Bohlebots-Sarcat/sarcat-bottom-pcb/README.md

# main/sarcat-bottom-pcb

## Sarcat PCB
___
Bohlebots Sarcat bottom circuit board
