Bohlebots-Sarcat/sarcat-bottom-pcb/bottomPCB/bottomPCB.kicad_pcb

## KiCad design bottomPCB/bottomPCB.kicad_pcb (2024-07-11)

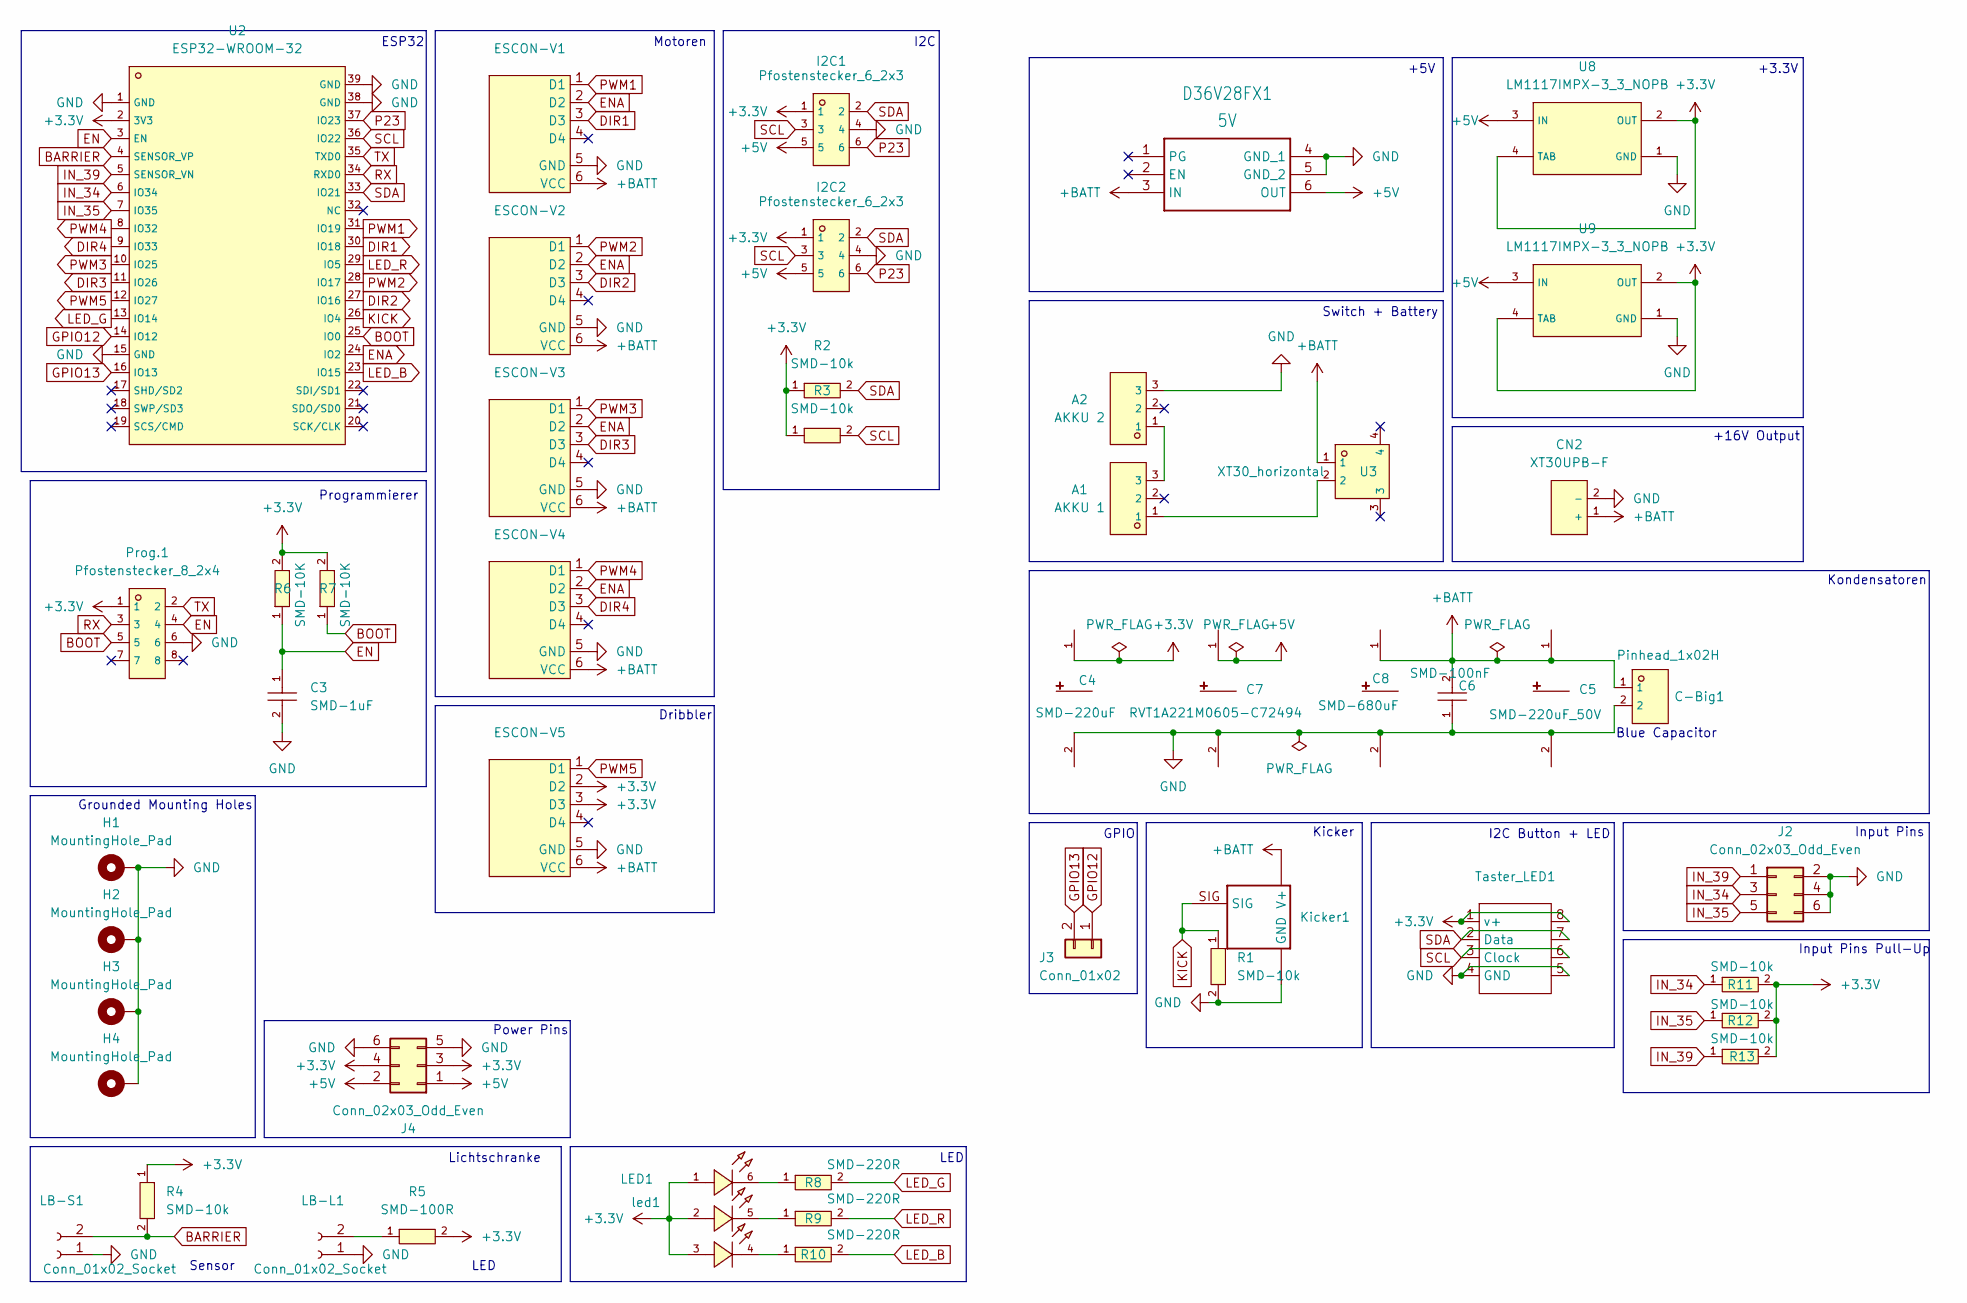
[picture p1: schematic bottomPCB.kicad_sch]

Parts:
A1: AKKU 1; CONN-TH_XH-3AW-C722865; LCSC C722865
A2: AKKU 2; CONN-TH_XH-3AW-C722865; LCSC C722865
C3: SMD-1uF; C0603; LCSC C1592
C4: SMD-220uF; CAP-SMD_BD10.0-L10.3-W10.3-LS11.3-FD; LCSC C125977
C5: SMD-220uF_50V; CAP-SMD_BD10.0-L10.3-W10.3-LS11.3-FD; LCSC C125977
C6: SMD-100nF; C0603; LCSC C30926
C7: RVT1A221M0605-C72494; CAP-SMD_BD10.0-L10.3-W10.3-LS11.3-FD; LCSC C125977
C8: SMD-680uF; CAP-SMD_BD10.0-L10.3-W10.3-LS11.3-FD; LCSC C335987
C-Big1: Pinhead_1x02H; HDR-TH_2P-P2.54-H-M-W10.4; LCSC C492410
CN2: XT30UPB-F; CONN-TH_XT30UPB-F; LCSC C108769
D36V28FX1: 5V; D36V28FX
ESCON-V1, ESCON-V2, ESCON-V3, ESCON-V4, ESCON-V5: ESCON-V
H1, H2, H3, H4: MountingHole_Pad; MountingHole_4.3mm_M4_Pad
I2C1, I2C2: Pfostenstecker_6_2x3; HDR-TH_6P-P2.54-V-F-R2-C3-S2.54-4; LCSC C5372863
J2, J4: Conn_02x03_Odd_Even; PinSocket_2x03_P2.54mm_Vertical
J3: Conn_01x02; PinSocket_1x02_P2.54mm_Vertical
Kicker1: KICKER
LB-L1: Conn_01x02_Socket; PinSocket_1x02_P2.54mm_Vertical
LB-S1: Conn_01x02_Socket; PinSocket_1x02_P2.54mm_Vertical
LED1: led1; LED-SMD_6P-L5.0-W5.0-TL_TC5050RGBF08; LCSC C784540
Prog.1: Pfostenstecker_8_2x4; IDC-TH_8P-P2.54-V-R2-C4-S2.54; LCSC C5372864
R1, R2, R3, R4, R11, R12, R13: SMD-10k; R0603; LCSC C25804
R5: SMD-100R; R0603; LCSC C22775
R6, R7: SMD-10K; R0603; LCSC C25804
R8, R9, R10: SMD-220R; R0603; LCSC C217883
Taster_LED1: TASTER_LED
U2: ESP32-WROOM-32; WIFIM-SMD_ESP32-WROOM-32-N4; LCSC C82899
U3: XT30_horizontal; CONN-TH_XT30PW-M; LCSC C431092
U8, U9: LM1117IMPX-3_3_NOPB; SOT-223_L6.5-W3.5-P2.30-LS7.0-BR; LCSC C23984

Connections:
+3.3V: C4.1, ESCON-V5.2 (D2), ESCON-V5.3 (D3), I2C1.1, I2C2.1, J4.3, J4.4, LED1.1 (+), LED1.2 (+), LED1.3 (+), Prog.1.1, R2.1, R3.1, R4.1, R5.2, R6.2, R7.2, R11.2, R12.2, R13.2, Taster_LED1.1 (v+), Taster_LED1.8, U2.2 (3V3), U8.2 (OUT), U8.4 (TAB), U9.2 (OUT), U9.4 (TAB)
+5V: C7.1, D36V28FX1.6 (OUT), I2C1.5, I2C2.5, J4.1, J4.2, U8.3 (IN), U9.3 (IN)
+BATT: C5.1, C6.2, C8.1, C-Big1.1, CN2.1 (+), D36V28FX1.3 (IN), ESCON-V1.6 (VCC), ESCON-V2.6 (VCC), ESCON-V3.6 (VCC), ESCON-V4.6 (VCC), ESCON-V5.6 (VCC), Kicker1.V+1 (V+), Kicker1.V+2 (V+), Kicker1.V+3 (V+), U3.1
BARRIER: LB-S1.2, R4.2, U2.4 (SENSOR_VP)
BOOT: Prog.1.5, R7.1, U2.25 (IO0)
DIR1: ESCON-V1.3 (D3), U2.30 (IO18)
DIR2: ESCON-V2.3 (D3), U2.27 (IO16)
DIR3: ESCON-V3.3 (D3), U2.11 (IO26)
DIR4: ESCON-V4.3 (D3), U2.9 (IO33)
EN: C3.1, Prog.1.4, R6.1, U2.3 (EN)
ENA: ESCON-V1.2 (D2), ESCON-V2.2 (D2), ESCON-V3.2 (D2), ESCON-V4.2 (D2), U2.24 (IO2)
GND: A2.3, C3.2, C4.2, C5.2, C6.1, C7.2, C8.2, C-Big1.2, CN2.2 (-), D36V28FX1.4 (GND_1), D36V28FX1.5 (GND_2), ESCON-V1.5 (GND), ESCON-V2.5 (GND), ESCON-V3.5 (GND), ESCON-V4.5 (GND), ESCON-V5.5 (GND), H1.1, H2.1, H3.1, H4.1, I2C1.4, I2C2.4, J2.2, J2.4, J2.6, J4.5, J4.6, Kicker1.GND1 (GND), Kicker1.GND2 (GND), Kicker1.GND3 (GND), Kicker1.GND4 (GND), Kicker1.GND5 (GND), Kicker1.GND6 (GND), Kicker1.GND7 (GND), Kicker1.GND8 (GND), LB-L1.1, LB-S1.1, Prog.1.6, R1.2, Taster_LED1.4 (GND), Taster_LED1.5, U2.1 (GND), U2.15 (GND), U2.38 (GND), U2.39 (GND), U8.1 (GND), U9.1 (GND)
GPIO12: J3.1, U2.14 (IO12)
GPIO13: J3.2, U2.16 (IO13)
IN_34: J2.3, R11.1, U2.6 (IO34)
IN_35: J2.5, R12.1, U2.7 (IO35)
IN_39: J2.1, R13.1, U2.5 (SENSOR_VN)
KICK: Kicker1.SIG, R1.1, U2.26 (IO4)
LED_B: R10.2, U2.23 (IO15)
LED_G: R8.2, U2.13 (IO14)
LED_R: R9.2, U2.29 (IO5)
unnamed: A1.1, U3.2
unnamed: A1.3, A2.1
unnamed: LB-L1.2, R5.1
unnamed: LED1.4 (-), R10.1
unnamed: LED1.5 (-), R9.1
unnamed: LED1.6 (-), R8.1
P23: I2C1.6, I2C2.6, U2.37 (IO23)
PWM1: ESCON-V1.1 (D1), U2.31 (IO19)
PWM2: ESCON-V2.1 (D1), U2.28 (IO17)
PWM3: ESCON-V3.1 (D1), U2.10 (IO25)
PWM4: ESCON-V4.1 (D1), U2.8 (IO32)
PWM5: ESCON-V5.1 (D1), U2.12 (IO27)
RX: Prog.1.3, U2.34 (RXD0)
SCL: I2C1.3, I2C2.3, R3.2, Taster_LED1.3 (Clock), Taster_LED1.6, U2.36 (IO22)
SDA: I2C1.2, I2C2.2, R2.2, Taster_LED1.2 (Data), Taster_LED1.7, U2.33 (IO21)
TX: Prog.1.2, U2.35 (TXD0)

Notes on the sheet:
Switch + Battery
Grounded Mounting Holes
Dribbler
LED
Motoren
Kondensatoren
+16V Output
I2C Button + LED
I2C
Input Pins
Input Pins Pull-Up
GPIO
Sensor
ESP32
+3.3V
LED
+5V
Kicker
Lichtschranke
Programmierer
Blue Capacitor
Power Pins

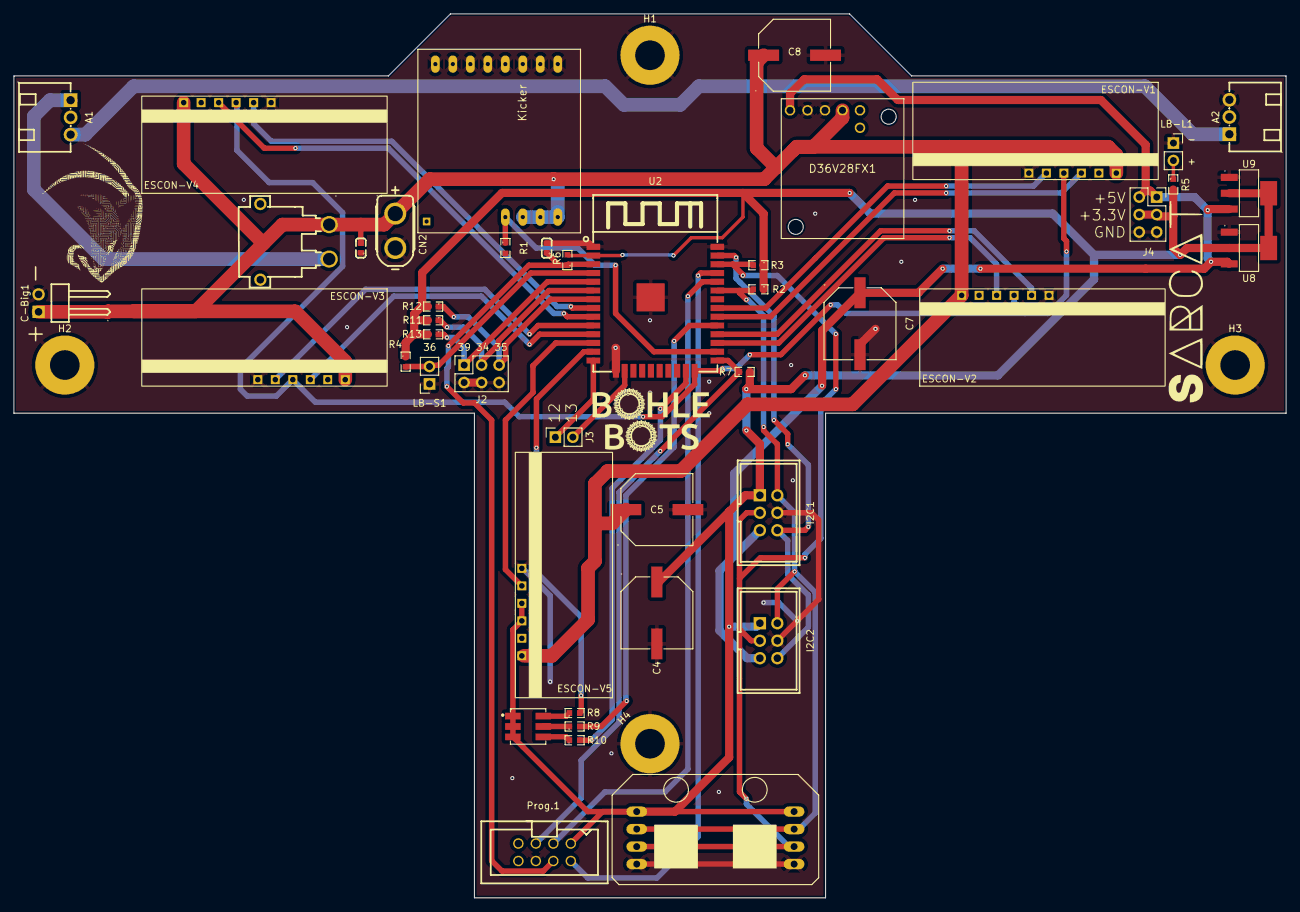
[picture p2: board bottomPCB.kicad_pcb from above]

Board: 2 copper layers, 184.8 x 128.4 mm, 48 parts (0 on the bottom side), 37 nets.
