Bohlebots-Sarcat/sarcat-bottom-pcb/(commit log)

2024-05-14 add kicad
    [bottomPCB.kicad_pcb, bottomPCB.kicad_sch]
2024-05-14 added basic parts
    [bottomPCB.kicad_sch]
2024-05-26 added motor symbol
    [bottomPCB.kicad_sch]
2024-05-26 added motor + drivers
    [bottomPCB.kicad_sch]
2024-05-27 added programmer
    [bottomPCB.kicad_sch]
2024-05-28 added kicker
    [bottomPCB.kicad_sch]
2024-05-29 simlified to one header pin
    [bottomPCB.kicad_sch]
2024-06-03 added i2c + kicker resistor
    [bottomPCB.kicad_sch]
2024-06-03 added programmer (boot/EN) Resistors + debounce capacitor
    [bottomPCB.kicad_sch]
2024-06-03 added power system + capacitators
    [bottomPCB.kicad_sch]
2024-06-04 added comments
    [bottomPCB.kicad_sch]
2024-06-04 replaced horizontal header pins with pin socket
    [bottomPCB.kicad_sch]
2024-06-04 added big blue capacitor
    [bottomPCB.kicad_sch]
2024-06-04 added dribbler
    [bottomPCB.kicad_pcb, bottomPCB.kicad_sch]
2024-06-04 improved wiring for motors
    [bottomPCB.kicad_sch]
2024-06-04 added i2c button interface
    [bottomPCB.kicad_sch]
2024-06-07 replaced +16V global net with +Batt power symbol
    [bottomPCB.kicad_sch]
2024-06-07 replaced dribbler escon driver with pins for external driver
    [bottomPCB.kicad_sch]
2024-06-07 removed unused nets
    [bottomPCB.kicad_sch]
2024-06-08 replaced 2000mA r78 a 5v Regulator with 4000mA D36V26FX 5v Regulator
    [bottomPCB.kicad_sch]
2024-06-08 added 16V output xt30 connector
    [bottomPCB.kicad_sch]
2024-06-09 added LED
    [bottomPCB.kicad_sch]
2024-06-10 added 3 Pullup-Input pins and 2 GPIO pins
    [bottomPCB.kicad_sch]
2024-06-10 added power pins
    [bottomPCB.kicad_sch]
2024-06-10 WIP: removed switch
    [bottomPCB.kicad_sch]
2024-06-14 connected ec 20 flat connectors to esp32
    [bottomPCB.kicad_sch]
2024-06-14 Import to PCB editor
    [bottomPCB.kicad_pcb]
2024-06-14 first placement of electronics on pcb
    [bottomPCB.kicad_pcb]
2024-06-14 draft of pcb outline + placement of electronics
    [bottomPCB.kicad_pcb, bottomPCB.kicad_sch]
2024-06-15 set edge cuts
    [bottomPCB.kicad_pcb]
2024-06-15 use edge cut polygons
    [bottomPCB.kicad_pcb]
2024-06-18 set edge cuts to octagon
    [bottomPCB.kicad_pcb]
2024-06-18 rearranged electronics to fit octagon
    [bottomPCB.kicad_pcb]
2024-06-18 added xt30 horizontal as switch
    [bottomPCB.kicad_sch]
2024-06-18 replaced smd connectors for ec flat with BohleBots standard
    [bottomPCB.kicad_pcb, bottomPCB.kicad_sch]
2024-06-18 set standard connectors for motors
    [bottomPCB.kicad_pcb]
2024-06-24 added vertical escon driver
    [bottomPCB.kicad_pcb]
2024-06-24 fixed wrong pin rotation in escon-v
2024-06-24 replaced escon drivers with vertical breakout board
    [bottomPCB.kicad_sch]
2024-06-24 updated pcb
    [bottomPCB.kicad_pcb]
2024-06-24 rearranged for vertical motor drivers
    [bottomPCB.kicad_pcb, bottomPCB.kicad_sch]
2024-06-24 added rules + changed layout
    [bottomPCB.kicad_pcb, bottomPCB.kicad_sch]
2024-06-25 set traces
    [bottomPCB.kicad_pcb, bottomPCB.kicad_sch]
2024-06-25 removed unconnected trace
    [bottomPCB.kicad_pcb]
2024-06-25 removed useless gnd traces
    [bottomPCB.kicad_pcb]
2024-06-25 added silk screen (polarity, pinout)
    [bottomPCB.kicad_pcb]
2024-06-25 centered mounting hole h1
    [bottomPCB.kicad_pcb]
2024-06-25 added logo
    [bottomPCB.kicad_pcb]
2024-06-25 added GND Vias for best possible ground plane
    [bottomPCB.kicad_pcb]
2024-06-25 moved Connectors to accomodate vertical drivers
    [bottomPCB.kicad_pcb]
2024-06-26 edited footprint for vertical Escon Driver
2024-06-26 moved drivers for motors 3 and 4 to acommodate switch
    [bottomPCB.kicad_pcb]
2024-06-26 edited footprint for vertical Escon Driver, set connector image to Fab Layer
2024-06-26 moved dribbler escon driver to accomodate connector
    [bottomPCB.kicad_pcb]
2024-06-26 made space for kicker
    [bottomPCB.kicad_pcb]
2024-06-26 Grounded Mounting Holes
    [bottomPCB.kicad_pcb, bottomPCB.kicad_sch]
2024-06-26 fixed isolated island issue
    [bottomPCB.kicad_pcb]
2024-06-26 Fixed clippes Sarcat label
    [bottomPCB.kicad_pcb]
2024-06-27 fixed erc errors
    [bottomPCB.kicad_sch]
2024-06-27 replaced esp32 footprint with new one
    [bottomPCB.kicad_pcb]
2024-07-01 Gerber Files
    [bottomPCB-B_Cu.gbl, bottomPCB-B_Mask.gbs, bottomPCB-B_Paste.gbp, bottomPCB-B_Silkscreen.gbo, bottomPCB-Edge_Cuts.gm1, bottomPCB-F_Cu.gtl, bottomPCB-F_Mask.gts, bottomPCB-F_Paste.gtp]
